Ava-chan/IOT_IR_Remote/Dokumentation/Header/Pakete.tex

% Anpassung an Landessprache
\usepackage[ngerman]{babel}	

\usepackage[T1]{fontenc}	
\usepackage[utf8]{inputenc}	
\usepackage{textcomp} 																% Euro-Zeichen und andere
\usepackage[babel,german=quotes]{csquotes}						% Anführungszeichen
\RequirePackage[ngerman=ngerman-x-latest]{hyphsubst} 	% erweiterte Silbentrennung

\usepackage{tocloft} %Wird benötigt damit das veränderte Counterverhalten nicht mit Text überlappt!
\usepackage{etoolbox} %Url Umbruch im Bibtex!

% Befehle aus AMSTeX für mathematische Symbole z.B. \boldsymbol \mathbb
\usepackage{amsmath,amsfonts}

% Zeilenabstände und Seitenränder 
\usepackage{setspace}
\usepackage{geometry}

% Einbinden von JPG-Grafiken
\usepackage{graphicx}

% zum Umfließen von Bildern
% Verwendung unter http://de.wikibooks.org/wiki/LaTeX-Kompendium:_Baukastensystem#textumflossene_Bilder
\usepackage{floatflt}

% Verwendung von vordefinierten Farbnamen zur Colorierung
% Palette und Verwendung unter http://kitt.cl.uzh.ch/kitt/CLinZ.CH/src/Kurse/archiv/LaTeX-Kurs-Farben.pdf
\usepackage[usenames,dvipsnames]{color} 

% Tabellen
\usepackage{array}
\usepackage{longtable}

% einfache Grafiken im Code
% Einführung unter http://www.math.uni-rostock.de/~dittmer/bsp/pstricks-bsp.pdf
%\usepackage{pstricks}

% Quellcodeansichten
%\usepackage{verbatim}
%\usepackage{moreverb} 											% für erweiterte Optionen der verbatim Umgebung
% Befehle und Beispiele unter http://www.ctex.org/documents/packages/verbatim/moreverb.pdf
%\usepackage{listings} 											% für angepasste Quellcodeansichten siehe
% Kurzeinführung unter http://blog.robert-kummer.de/2006/04/latex-quellcode-listing.html

% verlinktes und Farblich angepasstes Inhaltsverzeichnis
\usepackage[pdftex,
colorlinks=true,
linkcolor=InterneLinkfarbe,
urlcolor=ExterneLinkfarbe]{hyperref}
\usepackage[all]{hypcap}

% URL verlinken, lange URLs umbrechen
\usepackage{url}

% sorgt dafür, dass Leerzeichen hinter parameterlosen Makros nicht als Makroendezeichen interpretiert werden
\usepackage{xspace}

% Beschriftungen für Abbildungen und Tabellen
%\usepackage{caption}

%\usepackage{chngcntr}
%Ändert counterverhalten von figure, table usw..

% Entwicklerwarnmeldungen entfernen
%\usepackage{scrhack}
% Glossar und Abbildungsverzeichnis
%\usepackage[
%nonumberlist, %keine Seitenzahlen anzeigen
%acronym,      %ein Abkürzungsverzeichnis erstellen
%toc          %Einträge im Inhaltsverzeichnis
%]      %im Inhaltsverzeichnis auf section-Ebene erscheinen
%{glossaries}
\usepackage{makeidx}
\makeindex

\usepackage{amsmath, amssymb}

\usepackage[printonlyused]{acronym}
