Ava-chan/IOT_IR_Remote/CAD/in work screenshots/2016-03-17 00_52_16-000_CASE (Active) c__users_epetersen_documents_arduino_iot_ir_remote_cad_000_cas.png

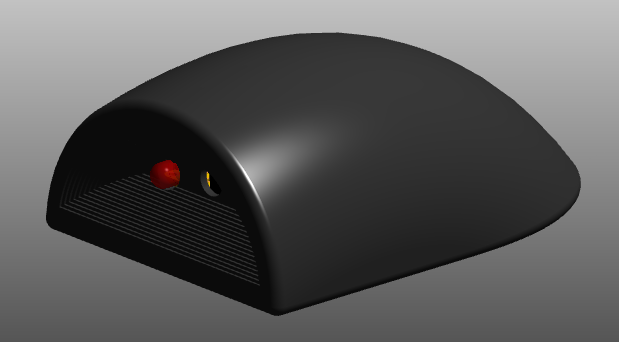
CAD/in work screenshots/2016-03-17 00_52_16-000_CASE (Active) c__users_epetersen_documents_arduino_iot_ir_remote_cad_000_cas.png
