Ava-chan/IOT_IR_Remote/CAD/Keyshot Renderings/KeyShot Render Image.5.jpg

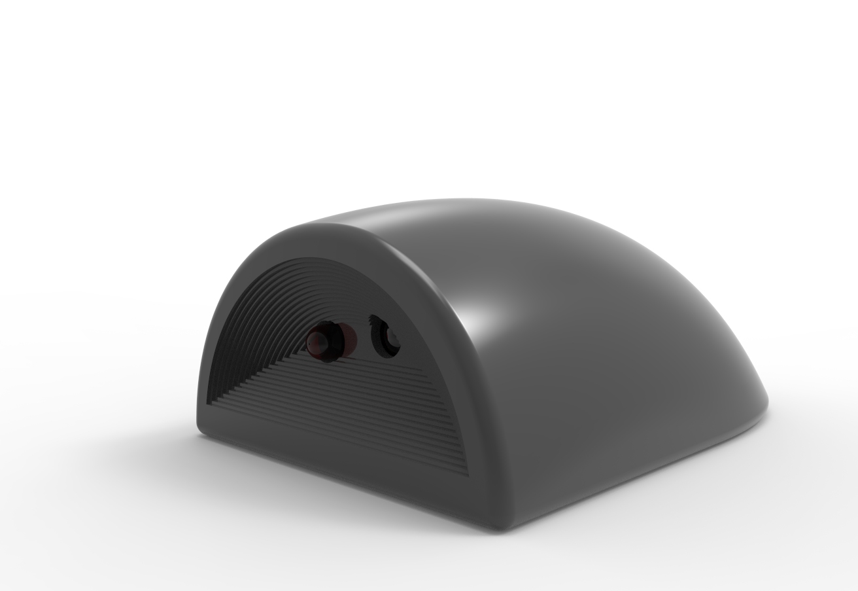
CAD/Keyshot Renderings/KeyShot Render Image.5.jpg
