Ava-chan/IOT_IR_Remote/(list of files, drawings)

Other design files:
ESP8266.fzz
