Ava-chan/IOT_IR_Remote/(commit log)

2016-01-08 Zusammenführung des Branches mit dem Master
2016-01-08 Anpassungen für das lesen und wiedergeben mit geringerem Speicherverbrauch
2016-01-08 Fixed Displaybuf of differend wlans...
    [IOT_IR_Remote.ino]
2016-01-18 Files nun wirklich hingefügt!
    [ESP8266.fzz]
2016-01-22 Latex Ich habe mal ein bisschen was aussortiert damit es auch in meinem MikTex baut IOT IR Remote - neuer Style - Record und Senden geht wieder sauber - Samsung klappt gut, Philips klappt nicht so gu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
2016-03-10 Doku fortgesetzt, aber noch nicht fertig, printAccessPoints aus ino entfernt
2016-03-13 Kleine Anpassungen an der Dokumentation ... aber noch nicht viel ... mache morgen abend weiter
2016-03-16 Bautteilliste und loop, setup erklärung added, PAP-beispiel zu testwecken hingefügt
2016-03-16 CAD Daten und Screenshots
2016-03-19 Buttons speichern, senden, ..., Erstimplementierung
2016-03-21 Nur Arduino Update
2016-03-21 todo PAP loop, und snstiges kleines zeug
2016-03-22 PAP loop und Verwendung zusammengelegt und vervollständigt
2016-03-22 CAD Daten Bilder (Schaltplan anpassung auf neue Widerstandsdarstellung) IOT_IR_Remote
2016-03-22 - Vortrag angefangen - CAD Modell renderings gemacht - Kleine Korrekturen in der Doku vorgenommen
2016-03-23 Kleinigkeiten und Todos eingefügt
2016-03-23 Bauteilliste fertig, Doku 95% fertig, der rest liegt bei dir;)
2016-03-23 Kleine Nacharbeiten und div. Fehlerkorrekturen
